vladimirsustek/RadioServer/Doc/SystemPinout.png

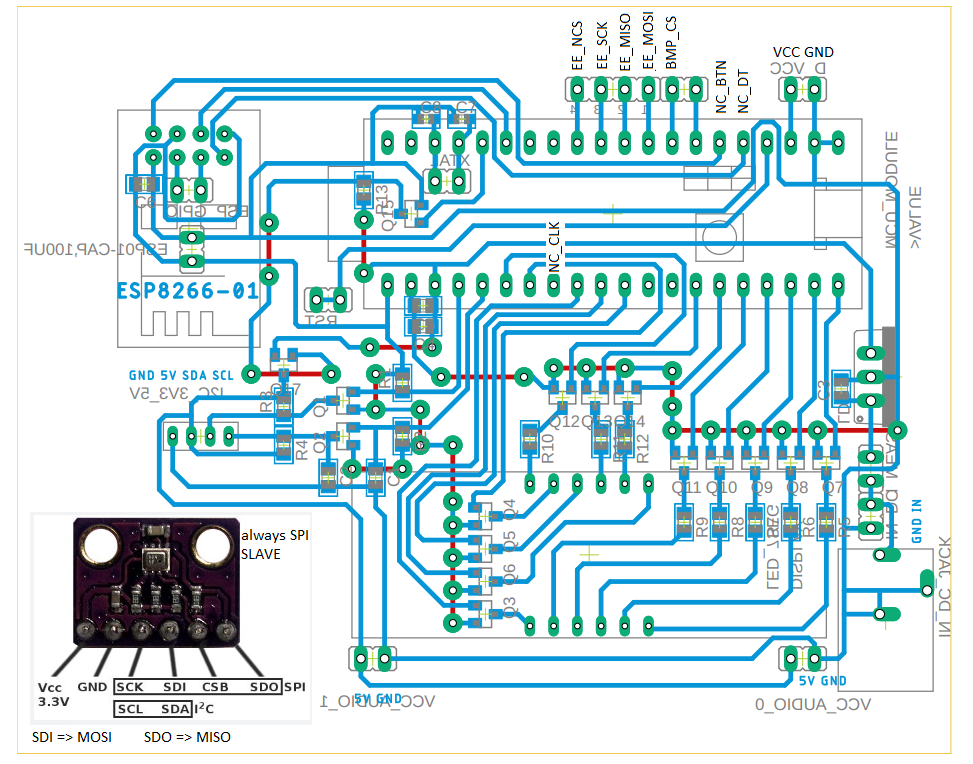
Doc/SystemPinout.png
