vladimirsustek/RadioServer/Hardware/RadioReceiver/RadioRX.pdf

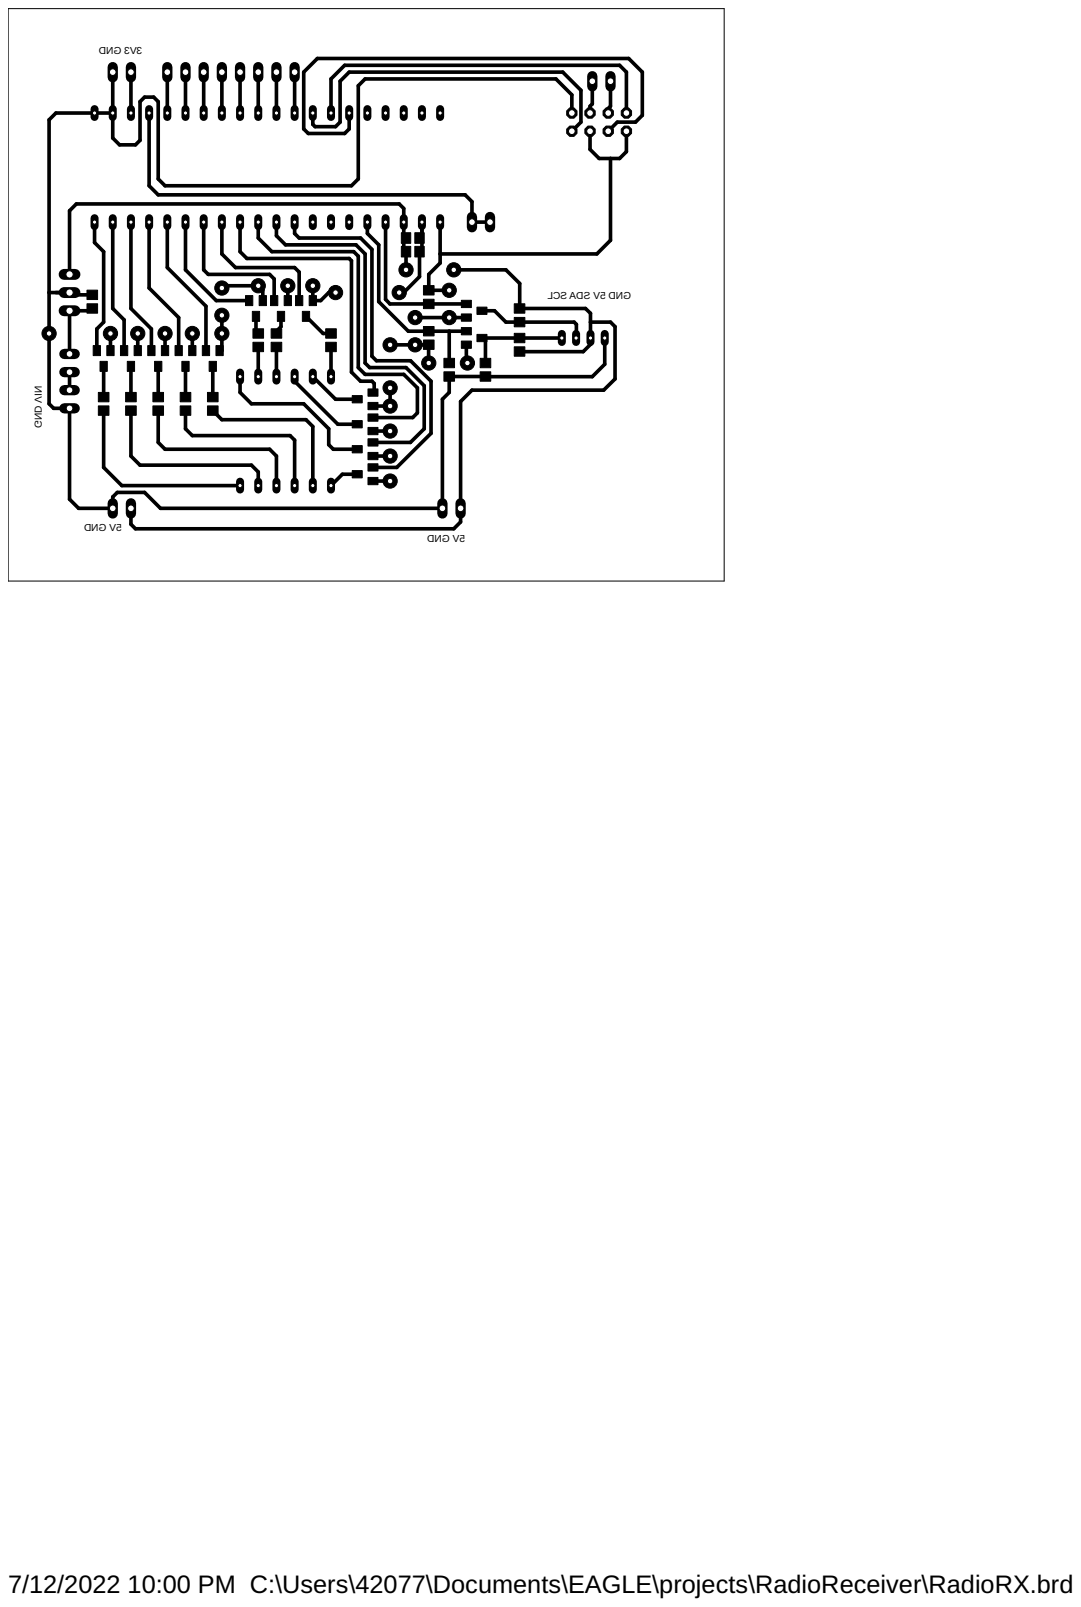
[picture p2: page 1]

7/12/2022 10:00 PM C:\Users\42077\Documents\EAGLE\projects\RadioReceiver\RadioRX.brd
