vladimirsustek/RadioServer/Hardware/RadioReceiver/RadioRX.brd

## EAGLE design Hardware/RadioReceiver/RadioRX.brd (2022-09-20)

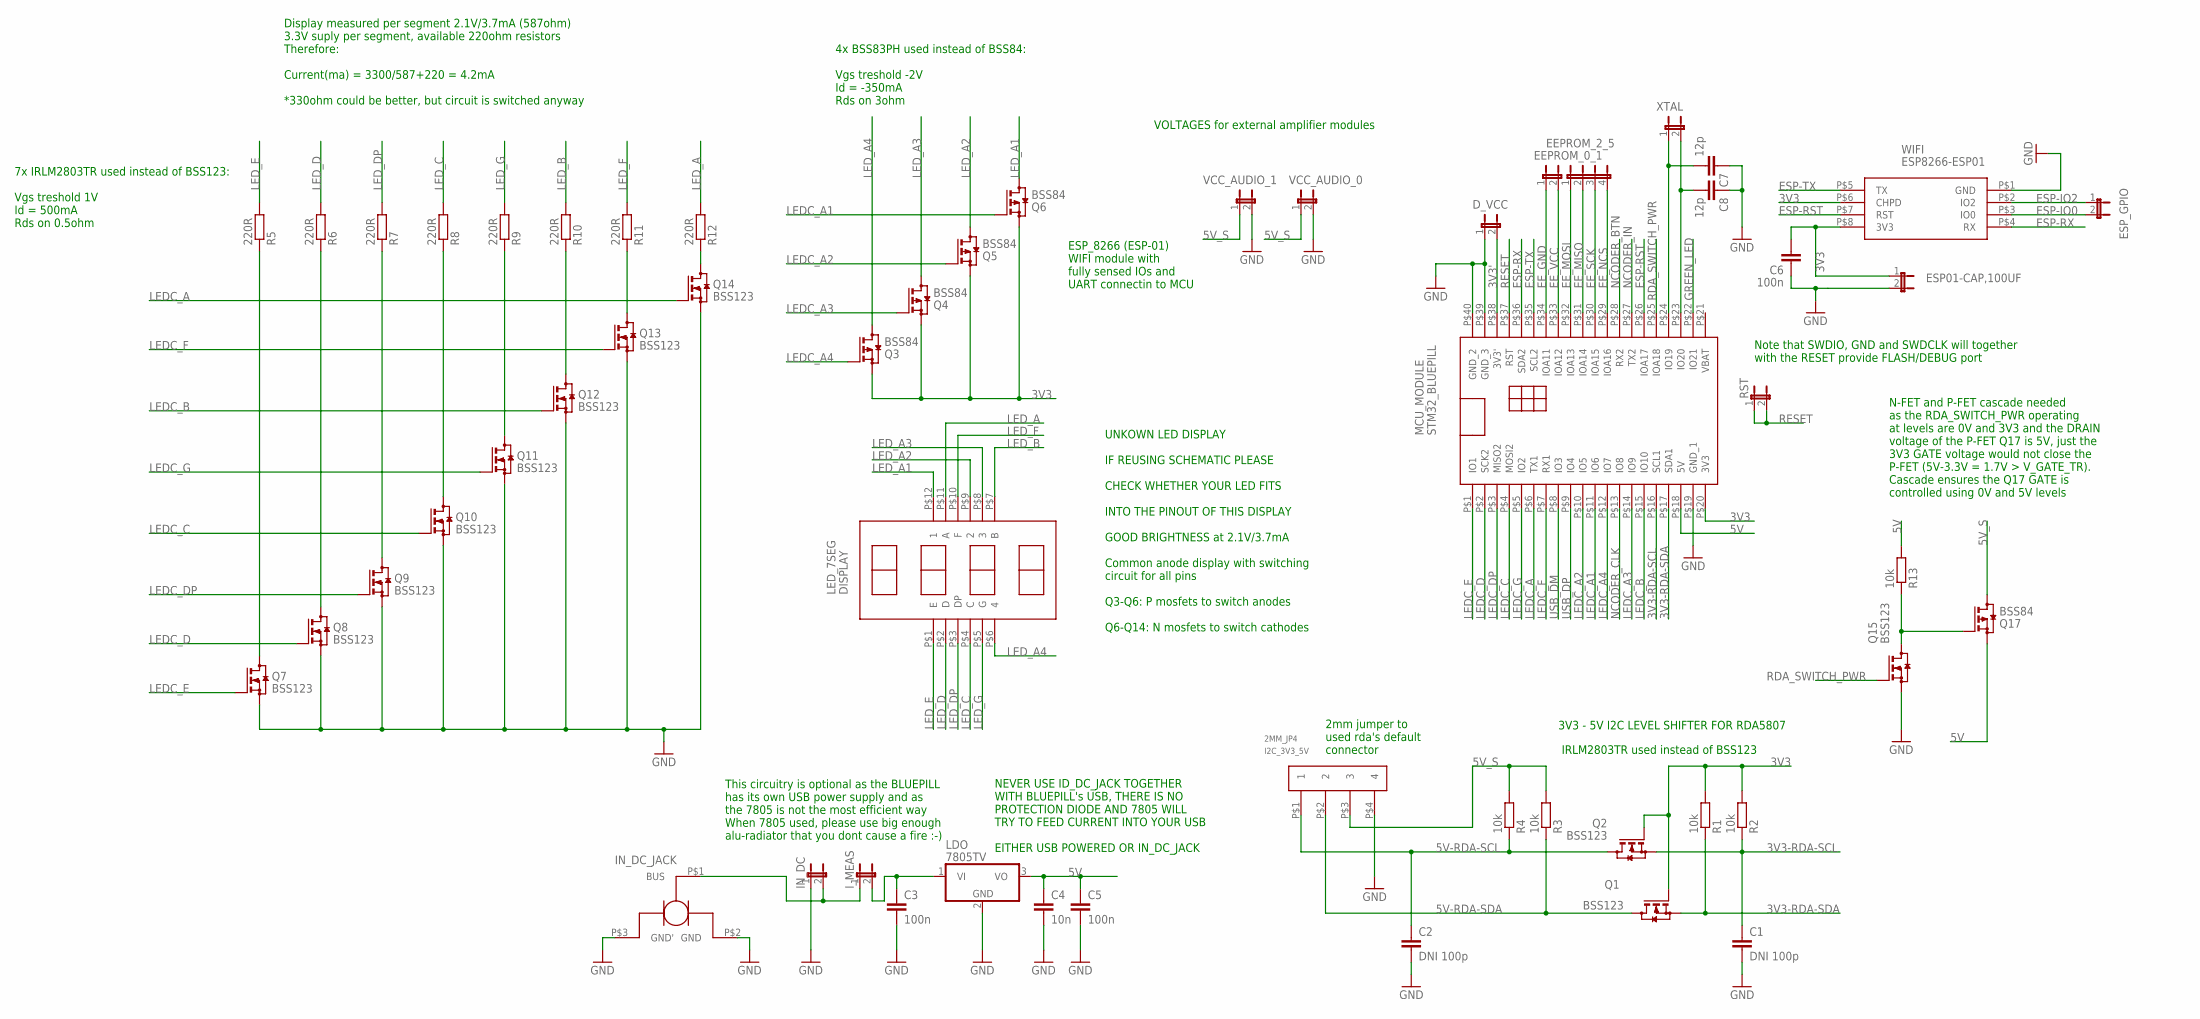
[picture p3: schematic RadioRX.sch]

Parts:
C1, C2: DNI 100p; C0805
C3, C5, C6: 100n; C0805
C4: 10n; C0805
C7, C8: 12p; C0603
DISPLAY: LED_7SEG
D_VCC: JP1E; JP1
EEPROM_0_1: JP1E; JP1
EEPROM_2_5: JP4E; JP4
ESP01-CAP,100UF: JP1E; JP1
ESP_GPIO: JP1E; JP1
I2C_3V3_5V: 2MM_JP4
IN_DC: JP1E; JP1
IN_DC_JACK: DC_CONN
I_MEAS: JP1E; JP1
LDO: 7805TV; TO220V
MCU_MODULE: STM32_BLUEPILL
Q1, Q2, Q7, Q8, Q9, Q10, Q11, Q12, Q13, Q14, Q15: BSS123; SOT23
Q3, Q4, Q5, Q6, Q17: BSS84; SOT23
R1, R2, R3, R4, R13: 10k; R0805
R5, R6, R7, R8, R9, R10, R11, R12: 220R; R0805
RST: JP1E; JP1
VCC_AUDIO_0, VCC_AUDIO_1: JP1E; JP1
WIFI: ESP8266-ESP01
XTAL: JP1E; JP1

Connections:
3V3: C6.2, ESP01-CAP,100UF.1, MCU_MODULE.P$20 (3V3), Q1.1 (G), Q2.1 (G), Q3.2 (S), Q4.2 (S), Q5.2 (S), Q6.2 (S), R1.2, R2.2, WIFI.P$6 (CHPD), WIFI.P$8 (3V3)
3V3': D_VCC.2, MCU_MODULE.P$38 (3V3')
3V3-RDA-SCL: C1.1, MCU_MODULE.P$16 (SCL1), Q2.2 (S), R2.1
3V3-RDA-SDA: MCU_MODULE.P$17 (SDA1), Q1.2 (S), R1.1
5V: C4.1, C5.1, LDO.3 (VO), MCU_MODULE.P$18 (5V), Q17.2 (S), R13.2
5V-RDA-SCL: C2.1, I2C_3V3_5V.P$1 (1), Q2.3 (D), R4.1
5V-RDA-SDA: I2C_3V3_5V.P$2 (2), Q1.3 (D), R3.1
5V_S: I2C_3V3_5V.P$3 (3), Q17.3 (D), R3.2, R4.2, VCC_AUDIO_0.1, VCC_AUDIO_1.1
EE_GND: EEPROM_0_1.1, MCU_MODULE.P$34 (IOA11)
EE_MISO: EEPROM_2_5.2, MCU_MODULE.P$31 (IOA14)
EE_MOSI: EEPROM_2_5.1, MCU_MODULE.P$32 (IOA13)
EE_NCS: EEPROM_2_5.4, MCU_MODULE.P$29 (IOA16)
EE_SCK: EEPROM_2_5.3, MCU_MODULE.P$30 (IOA15)
EE_VCC: EEPROM_0_1.2, MCU_MODULE.P$33 (IOA12)
ESP-IO0: ESP_GPIO.2, WIFI.P$3 (IO0)
ESP-IO2: ESP_GPIO.1, WIFI.P$2 (IO2)
ESP-RST: MCU_MODULE.P$26 (IOA17), WIFI.P$7 (RST)
ESP-RX: MCU_MODULE.P$36 (SDA2), WIFI.P$4 (RX)
ESP-TX: MCU_MODULE.P$35 (SCL2), WIFI.P$5 (TX)
GND: C1.2, C2.2, C3.2, C4.2, C5.2, C6.1, C7.1, C8.1, D_VCC.1, ESP01-CAP,100UF.2, I2C_3V3_5V.P$4 (4), IN_DC.1, IN_DC_JACK.P$2 (GND), IN_DC_JACK.P$3 (GND'), LDO.2 (GND), MCU_MODULE.P$19 (GND_1), MCU_MODULE.P$39 (GND_3), MCU_MODULE.P$40 (GND_2), Q7.2 (S), Q8.2 (S), Q9.2 (S), Q10.2 (S), Q11.2 (S), Q12.2 (S), Q13.2 (S), Q14.2 (S), Q15.2 (S), VCC_AUDIO_0.2, VCC_AUDIO_1.2, WIFI.P$1 (GND)
GREEN_LED: MCU_MODULE.P$22 (IO21)
LEDC_A: MCU_MODULE.P$6 (TX1), Q14.1 (G)
LEDC_A1: MCU_MODULE.P$11 (IO6), Q6.1 (G)
LEDC_A2: MCU_MODULE.P$10 (IO5), Q5.1 (G)
LEDC_A3: MCU_MODULE.P$14 (IO9), Q4.1 (G)
LEDC_A4: MCU_MODULE.P$12 (IO7), Q3.1 (G)
LEDC_B: MCU_MODULE.P$15 (IO10), Q12.1 (G)
LEDC_C: MCU_MODULE.P$4 (MOSI2), Q10.1 (G)
LEDC_D: MCU_MODULE.P$2 (SCK2), Q8.1 (G)
LEDC_DP: MCU_MODULE.P$3 (MISO2), Q9.1 (G)
LEDC_E: MCU_MODULE.P$1 (IO1), Q7.1 (G)
LEDC_F: MCU_MODULE.P$7 (RX1), Q13.1 (G)
LEDC_G: MCU_MODULE.P$5 (IO2), Q11.1 (G)
LED_A: DISPLAY.P$11 (A), R12.2
LED_A1: DISPLAY.P$12 (1), Q6.3 (D)
LED_A2: DISPLAY.P$9 (2), Q5.3 (D)
LED_A3: DISPLAY.P$8 (3), Q4.3 (D)
LED_A4: DISPLAY.P$6 (4), Q3.3 (D)
LED_B: DISPLAY.P$7 (B), R10.2
LED_C: DISPLAY.P$4 (C), R8.2
LED_D: DISPLAY.P$2 (D), R6.2
LED_DP: DISPLAY.P$3 (DP), R7.2
LED_E: DISPLAY.P$1 (E), R5.2
LED_F: DISPLAY.P$10 (F), R11.2
LED_G: DISPLAY.P$5 (G), R9.2
unnamed: C3.1, I_MEAS.2, LDO.1 (VI)
unnamed: IN_DC.2, IN_DC_JACK.P$1 (BUS), I_MEAS.1
unnamed: C8.2, MCU_MODULE.P$23 (IO20), XTAL.2
unnamed: C7.2, MCU_MODULE.P$24 (IO19), XTAL.1
unnamed: Q15.3 (D), Q17.1 (G), R13.1
unnamed: Q7.3 (D), R5.1
unnamed: Q8.3 (D), R6.1
unnamed: Q9.3 (D), R7.1
unnamed: Q10.3 (D), R8.1
unnamed: Q11.3 (D), R9.1
unnamed: Q12.3 (D), R10.1
unnamed: Q13.3 (D), R11.1
unnamed: Q14.3 (D), R12.1
NCODER_BTN: MCU_MODULE.P$28 (RX2)
NCODER_CLK: MCU_MODULE.P$13 (IO8)
NCODER_IN: MCU_MODULE.P$27 (TX2)
RDA_SWITCH_PWR: MCU_MODULE.P$25 (IOA18), Q15.1 (G)
RESET: MCU_MODULE.P$37 (RST), RST.1, RST.2
USB_DM: MCU_MODULE.P$8 (IO3)
USB_DP: MCU_MODULE.P$9 (IO4)

Notes on the sheet:
ESP_8266 (ESP-01) WIFI module with fully sensed IOs and UART connectin to MCU
VOLTAGES for external amplifier modules
3V3 - 5V I2C LEVEL SHIFTER FOR RDA5807
7x IRLM2803TR used instead of BSS123: Vgs treshold 1V Id = 500mA Rds on 0.5ohm
4x BSS83PH used instead of BSS84: Vgs treshold -2V Id = -350mA Rds on 3ohm
UNKOWN LED DISPLAY IF REUSING SCHEMATIC PLEASE CHECK WHETHER YOUR LED FITS INTO THE PINOUT OF THIS DISPLAY GOOD BRIGHTNESS at 2.1V/3.7mA Common anode display with switching circuit for all pins Q3-Q6: P mosfets to switch anodes Q6-Q14: N mosfets to switch cathodes
2mm jumper to used rda's default connector
IRLM2803TR used instead of BSS123
Display measured per segment 2.1V/3.7mA (587ohm) 3.3V suply per segment, available 220ohm resistors Therefore: Current(ma) = 3300/587+220 = 4.2mA *330ohm could be better, but circuit is switched anyway
Note that SWDIO, GND and SWDCLK will together with the RESET provide FLASH/DEBUG port
N-FET and P-FET cascade needed as the RDA_SWITCH_PWR operating at levels are 0V and 3V3 and the DRAIN voltage of the P-FET Q17 is 5V, just the 3V3 GATE voltage would not close the P-FET (5V-3.3V = 1.7V > V_GATE_TR). Cascade ensures the Q17 GATE is controlled using 0V and 5V levels
This circuitry is optional as the BLUEPILL has its own USB power supply and as the 7805 is not the most efficient way When 7805 used, please use big enough alu-radiator that you dont cause a fire :-)
NEVER USE ID_DC_JACK TOGETHER WITH BLUEPILL's USB, THERE IS NO PROTECTION DIODE AND 7805 WILL TRY TO FEED CURRENT INTO YOUR USB EITHER USB POWERED OR IN_DC_JACK

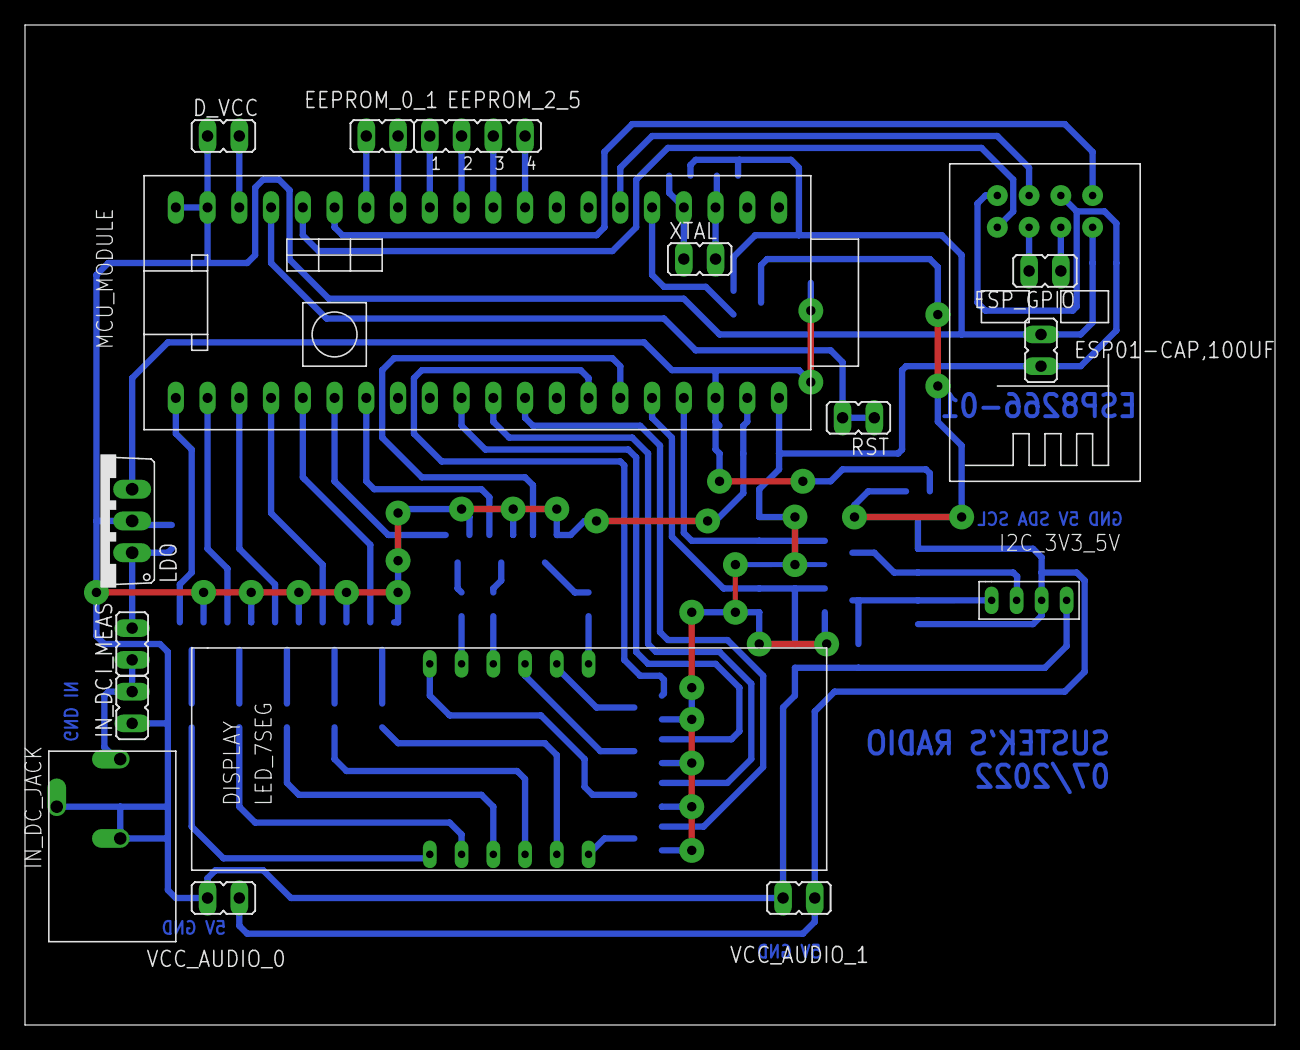
[picture p4: board RadioRX.brd from above]

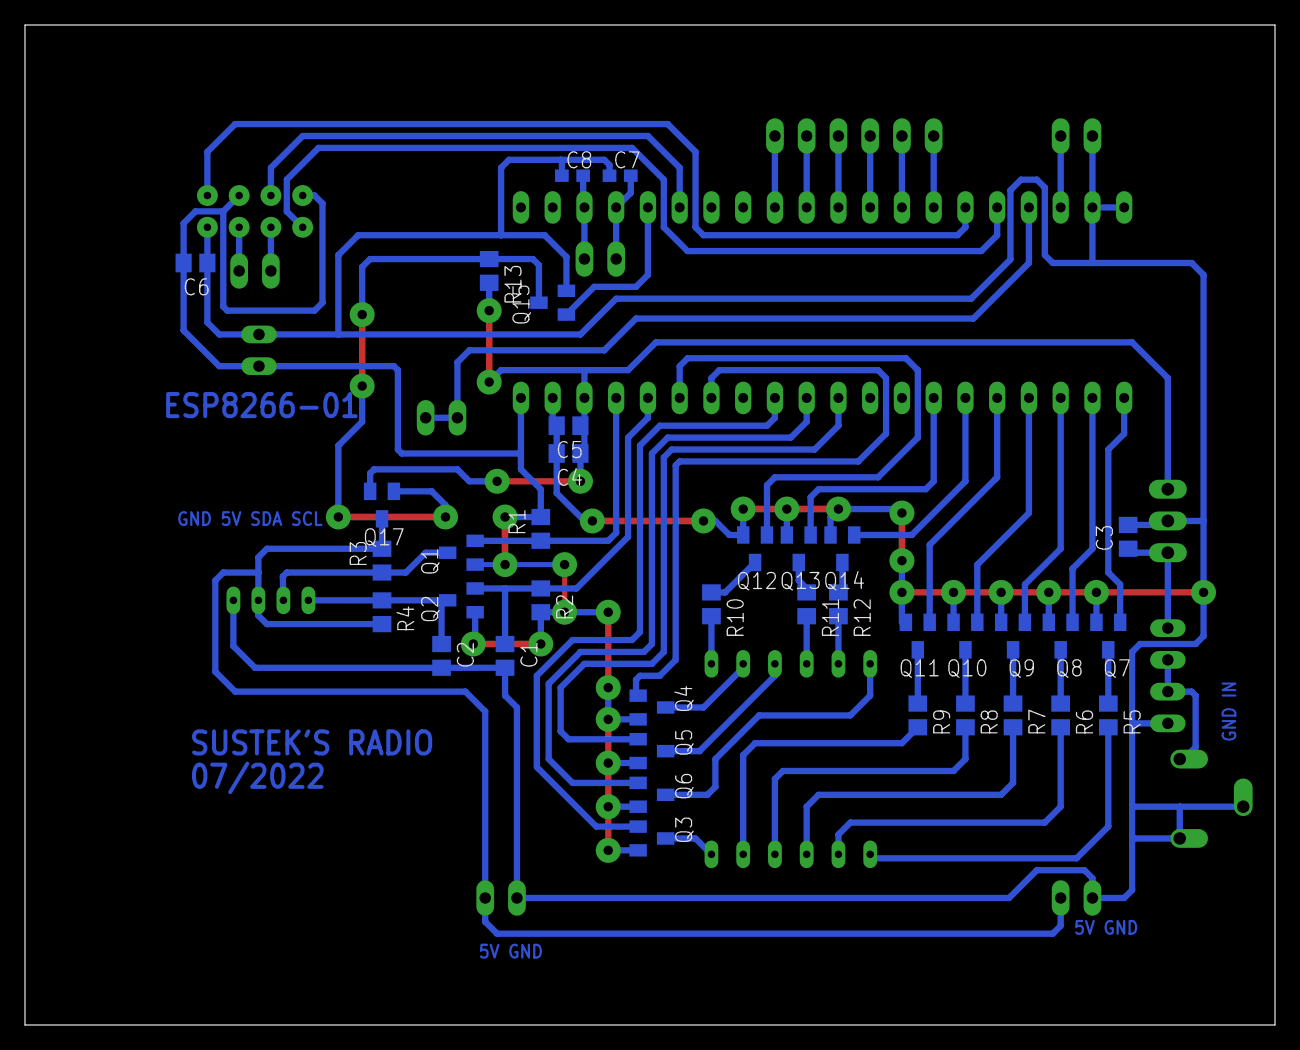
[picture p5: board RadioRX.brd from below]

Board: 2 copper layers, 100.0 x 80.0 mm, 54 parts (37 on the bottom side), 59 nets.
