vladimirsustek/RadioServer/Hardware/RadioReceiver/EEPROM_Modul.brd

## EAGLE design Hardware/RadioReceiver/EEPROM_Modul.brd (2022-09-02)

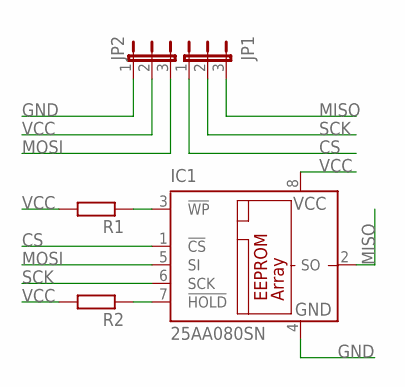
[picture p6: schematic EEPROM_Modul.sch]

Parts:
IC1: 25AA080SN; SO-08
JP1, JP2: JP2E; JP2
R1, R2: R-EU_R0805; R0805

Connections:
CS: IC1.1 (!CS), JP1.1
GND: IC1.4 (GND), JP2.1
MISO: IC1.2 (SO), JP1.3
MOSI: IC1.5 (SI), JP2.3
unnamed: IC1.3 (!WP), R1.1
unnamed: IC1.7 (!HOLD), R2.1
SCK: IC1.6 (SCK), JP1.2
VCC: IC1.8 (VCC), JP2.2, R1.2, R2.2

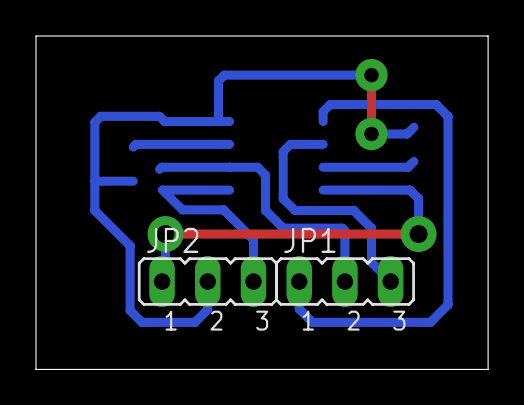
[picture p7: board EEPROM_Modul.brd from above]

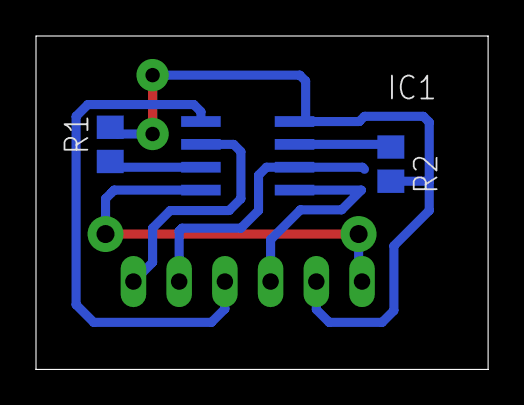
[picture p8: board EEPROM_Modul.brd from below]

Board: 2 copper layers, 25.1 x 18.5 mm, 5 parts (3 on the bottom side), 8 nets.
