vladimirsustek/RadioServer/Core/Src/main.c

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
/* Includes ------------------------------------------------------------------*/
#include "main.h"
#include "dma.h"
#include "i2c.h"
#include "rtc.h"
#include "spi.h"
#include "tim.h"
#include "usart.h"
#include "usb_device.h"
#include "gpio.h"

/* USER CODE BEGIN Includes */
#include <string.h>
#include <stdio.h>

#include "stm32f1xx_hal_conf.h"
#include "usbd_cdc_if.h"

#include "esp8266_http_server.h"
#include "rda5807m.h"
#include "cmd_dispatcher.h"
#include "eeprom_25aa1024.h"

#include "bmp280.h"
#include "app.h"
/* USER CODE END Includes */


/* USER CODE BEGIN PV */
UART_HandleTypeDef huart2;
DMA_HandleTypeDef hdma_usart2_rx;

/* USER CODE END PV */

void SystemClock_Config(void);
/**
  * @brief  The application entry point.
  * @retval int
  */
int main(void)
{
  /* USER CODE BEGIN 1 */
	uint8_t* rxStrBuff = NULL;
	char *pHTTPReq = NULL;
	char stateMessage[APP_MESSAGE_LNG] = {0};
    uint32_t rxStrlng;
    uint32_t httpReqLng = 0;
    RTC_TimeTypeDef rtcStruct = {0};

  /* USER CODE END 1 */

  /* MCU Configuration--------------------------------------------------------*/

  /* Reset of all peripherals, Initializes the Flash interface and the Systick. */
  HAL_Init();

  /* Configure the system clock */
  SystemClock_Config();

  /* USER CODE BEGIN SysInit */
  APP_ShortcutUSB();
  /* USER CODE END SysInit */

  /* Initialize all configured peripherals */
  MX_GPIO_Init();
  MX_I2C1_Init();
  MX_TIM2_Init();
  MX_DMA_Init();
  MX_USB_DEVICE_Init();
  MX_USART3_UART_Init();
  MX_SPI1_Init();
  MX_RTC_Init();
  /* USER CODE BEGIN 2 */

  APP_LEDC_DisplayInit();
  APP_BMP280_SensorInit();
  APP_EEPROM_CheckIfOk();
  APP_RDA5807M_RadioInit();
  APP_RTC_Init();

  if (systemGlobalState.states.espEnabled)
  {
	  APP_ESP_InitConnect();
  }

  APPP_NCoderStart();

  /* USER CODE END 2 */

  /* Infinite loop */
  /* USER CODE BEGIN WHILE */
  while (1)
  {
    /* USER CODE END WHILE */

    /* USER CODE BEGIN 3 */

	  // VCOM RX routine
      rxStrBuff = VCOMFetchReceivedLine(&rxStrlng);

      if (NULL != rxStrBuff)
      {
          /* If so and is terminated by <LF>,
             process it as command*/
    	  BluePill_SetBlinkState(THREE_BLINKS);
          CmdDispatch(rxStrBuff, rxStrlng);
      }

	  if (systemGlobalState.states.espEnabled)
	  {
	      // Function returns ESP_RET_OK when HTTP request received
	      if(ESP_RET_OK == ESP_CheckReceiveHTTP(&pHTTPReq, &httpReqLng))
	      {
	    	  // Process the request
	    	  BluePill_SetBlinkState(THREE_BLINKS);
	          ESP_ProcessHTTP(pHTTPReq, httpReqLng);
	      }
	  }

      // If triggered display frequency, volume or time HH:MM settings
      if (NO_SETTINGS_ONGOING == APP_UserInput(stateMessage, &rtcStruct))
      {
          // Periodic time/temp display + fault detection
          APP_ModuleCheckStates(stateMessage, &rtcStruct);
      }

  }
  /* USER CODE END 3 */
}

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
