vladimirsustek/RadioServer/Core/Inc/main.h

#define GREEN_LED_Pin GPIO_PIN_13
#define GREEN_LED_GPIO_Port GPIOC
#define RDA_SWITCH_PWR_Pin GPIO_PIN_0
#define RDA_SWITCH_PWR_GPIO_Port GPIOA
#define ESP_RST_Pin GPIO_PIN_1
#define ESP_RST_GPIO_Port GPIOA
#define NCODER_DT_Pin GPIO_PIN_3
#define NCODER_DT_GPIO_Port GPIOA
#define NCODER_BTN_Pin GPIO_PIN_2
#define NCODER_BTN_GPIO_Port GPIOA
#define SPI1_NCS_Pin GPIO_PIN_4
#define SPI1_NCS_GPIO_Port GPIOA
#define BMP_CS_Pin GPIO_PIN_0
#define BMP_CS_GPIO_Port GPIOB
#define LEDC_E_Pin GPIO_PIN_12
#define LEDC_E_GPIO_Port GPIOB
#define LEDC_D_Pin GPIO_PIN_13
#define LEDC_D_GPIO_Port GPIOB
#define LEDC_DP_Pin GPIO_PIN_14
#define LEDC_DP_GPIO_Port GPIOB
#define LEDC_C_Pin GPIO_PIN_15
#define LEDC_C_GPIO_Port GPIOB
#define LEDC_G_Pin GPIO_PIN_8
#define LEDC_G_GPIO_Port GPIOA
#define LEDC_A_Pin GPIO_PIN_9
#define LEDC_A_GPIO_Port GPIOA
#define LEDC_F_Pin GPIO_PIN_10
#define LEDC_F_GPIO_Port GPIOA
#define LEDC_A2_Pin GPIO_PIN_15
#define LEDC_A2_GPIO_Port GPIOA
#define LEDC_A1_Pin GPIO_PIN_3
#define LEDC_A1_GPIO_Port GPIOB
#define LEDC_A4_Pin GPIO_PIN_4
#define LEDC_A4_GPIO_Port GPIOB
#define NCODER_CLK_Pin GPIO_PIN_5
#define NCODER_CLK_GPIO_Port GPIOB
#define LEDC_B_Pin GPIO_PIN_6
#define LEDC_B_GPIO_Port GPIOB
#define LEDC_A3_Pin GPIO_PIN_7
#define LEDC_A3_GPIO_Port GPIOB
