vladimirsustek/RadioServer/Core/Src/gpio.c

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

/* Includes ------------------------------------------------------------------*/
#include "gpio.h"

/* USER CODE BEGIN 0 */
static BluePillGreenLed_t blinkState = NO_BLINK;
static uint8_t div200to20Hz = 0;
static uint8_t intState = 0;
/* USER CODE END 0 */

/*----------------------------------------------------------------------------*/
/* Configure GPIO                                                             */
/*----------------------------------------------------------------------------*/
/** Configure pins as
        * Analog
        * Input
        * Output
        * EVENT_OUT
        * EXTI
        * Free pins are configured automatically as Analog (this feature is enabled through
        * the Code Generation settings)
*/
void MX_GPIO_Init(void)
{

  GPIO_InitTypeDef GPIO_InitStruct = {0};

  /* GPIO Ports Clock Enable */
  __HAL_RCC_GPIOC_CLK_ENABLE();
  __HAL_RCC_GPIOD_CLK_ENABLE();
  __HAL_RCC_GPIOA_CLK_ENABLE();
  __HAL_RCC_GPIOB_CLK_ENABLE();

  /*Configure GPIO pin Output Level */
  HAL_GPIO_WritePin(GREEN_LED_GPIO_Port, GREEN_LED_Pin, GPIO_PIN_SET);

  /*Configure GPIO pin Output Level */
  HAL_GPIO_WritePin(GPIOA, RDA_SWITCH_PWR_Pin|LEDC_G_Pin|LEDC_A_Pin|LEDC_F_Pin, GPIO_PIN_RESET);

  /*Configure GPIO pin Output Level */
  HAL_GPIO_WritePin(GPIOA, SPI1_NCS_Pin|LEDC_A2_Pin, GPIO_PIN_SET);

  /*Configure GPIO pin Output Level */
  HAL_GPIO_WritePin(GPIOB, BMP_CS_Pin|LEDC_A1_Pin|LEDC_A4_Pin|LEDC_A3_Pin, GPIO_PIN_SET);

  /*Configure GPIO pin Output Level */
  HAL_GPIO_WritePin(GPIOB, LEDC_E_Pin|LEDC_D_Pin|LEDC_DP_Pin|LEDC_C_Pin
                          |LEDC_B_Pin, GPIO_PIN_RESET);

  /*Configure GPIO pin : PtPin */
  GPIO_InitStruct.Pin = GREEN_LED_Pin;
  GPIO_InitStruct.Mode = GPIO_MODE_OUTPUT_PP;
  GPIO_InitStruct.Pull = GPIO_NOPULL;
  GPIO_InitStruct.Speed = GPIO_SPEED_FREQ_LOW;
  HAL_GPIO_Init(GREEN_LED_GPIO_Port, &GPIO_InitStruct);

  /*Configure GPIO pins : PAPin PAPin PAPin PAPin
                           PAPin */
  GPIO_InitStruct.Pin = RDA_SWITCH_PWR_Pin|LEDC_G_Pin|LEDC_A_Pin|LEDC_F_Pin
                          |LEDC_A2_Pin;
  GPIO_InitStruct.Mode = GPIO_MODE_OUTPUT_PP;
  GPIO_InitStruct.Pull = GPIO_NOPULL;
  GPIO_InitStruct.Speed = GPIO_SPEED_FREQ_LOW;
  HAL_GPIO_Init(GPIOA, &GPIO_InitStruct);

  /*Configure GPIO pins : PAPin PAPin PAPin */
  GPIO_InitStruct.Pin = ESP_RST_Pin|NCODER_DT_Pin|NCODER_BTN_Pin;
  GPIO_InitStruct.Mode = GPIO_MODE_INPUT;
  GPIO_InitStruct.Pull = GPIO_NOPULL;
  HAL_GPIO_Init(GPIOA, &GPIO_InitStruct);

  /*Configure GPIO pin : PtPin */
  GPIO_InitStruct.Pin = SPI1_NCS_Pin;
  GPIO_InitStruct.Mode = GPIO_MODE_OUTPUT_PP;
  GPIO_InitStruct.Pull = GPIO_NOPULL;
  GPIO_InitStruct.Speed = GPIO_SPEED_FREQ_HIGH;
  HAL_GPIO_Init(SPI1_NCS_GPIO_Port, &GPIO_InitStruct);

  /*Configure GPIO pins : PBPin PBPin PBPin PBPin
                           PBPin PBPin PBPin PBPin
                           PBPin */
  GPIO_InitStruct.Pin = BMP_CS_Pin|LEDC_E_Pin|LEDC_D_Pin|LEDC_DP_Pin
                          |LEDC_C_Pin|LEDC_A1_Pin|LEDC_A4_Pin|LEDC_B_Pin
                          |LEDC_A3_Pin;
  GPIO_InitStruct.Mode = GPIO_MODE_OUTPUT_PP;
  GPIO_InitStruct.Pull = GPIO_NOPULL;
  GPIO_InitStruct.Speed = GPIO_SPEED_FREQ_LOW;
  HAL_GPIO_Init(GPIOB, &GPIO_InitStruct);

  /*Configure GPIO pins : PB1 PB2 */
  GPIO_InitStruct.Pin = GPIO_PIN_1|GPIO_PIN_2;
  GPIO_InitStruct.Mode = GPIO_MODE_ANALOG;
  HAL_GPIO_Init(GPIOB, &GPIO_InitStruct);

  /*Configure GPIO pin : PtPin */
  GPIO_InitStruct.Pin = NCODER_CLK_Pin;
  GPIO_InitStruct.Mode = GPIO_MODE_INPUT;
  GPIO_InitStruct.Pull = GPIO_NOPULL;
  HAL_GPIO_Init(NCODER_CLK_GPIO_Port, &GPIO_InitStruct);

}

/* USER CODE BEGIN 2 */

// to be called 1x per 50ms
void BluePill_GreenLedService(void)
{
	if (0 == div200to20Hz)
	{
		div200to20Hz = (div200to20Hz + 1 % 20);

		switch(blinkState)
		{
		case ONCE_BLINK :
		{
			if (0 == intState)
			{
				HAL_GPIO_WritePin(GREEN_LED_GPIO_Port, GREEN_LED_Pin, GPIO_PIN_RESET);
			}
			else
			{
				HAL_GPIO_WritePin(GREEN_LED_GPIO_Port, GREEN_LED_Pin, GPIO_PIN_SET);
			}
			intState = (intState + 1) % 10;
			if (0 == intState) blinkState = NO_BLINK;
		}
		break;
		case THREE_BLINKS :
		{
			switch(intState)
			{
			case 0:
			case 2:
			case 4:
			{
				HAL_GPIO_WritePin(GREEN_LED_GPIO_Port, GREEN_LED_Pin, GPIO_PIN_RESET);
			}
			break;
			default :
			{
				HAL_GPIO_WritePin(GREEN_LED_GPIO_Port, GREEN_LED_Pin, GPIO_PIN_SET);
			}
			}
			intState = (intState + 1) % 10;
			if (0 == intState) blinkState = NO_BLINK;
		}
		break;
		case PERMANENT_BLINK :
		{
			HAL_GPIO_TogglePin(GREEN_LED_GPIO_Port, GREEN_LED_Pin);
			intState = 0;
		}
		break;
		default :
		{
			blinkState = NO_BLINK;

			/* If LED is on turn it off */
			if (!HAL_GPIO_ReadPin(GREEN_LED_GPIO_Port, GREEN_LED_Pin))
				HAL_GPIO_WritePin(GREEN_LED_GPIO_Port, GREEN_LED_Pin, GPIO_PIN_SET);
		}
		break;
		}
	}
	else
	{
		div200to20Hz = (div200to20Hz + 1) % 20;
	}

}

void BluePill_SetBlinkState(BluePillGreenLed_t st)
{
	blinkState = st;
	div200to20Hz = 0;
	intState = 0;
}

/* USER CODE END 2 */
