vladimirsustek/RadioServer/rda5807m/Src/rda5807m.c

#include "rda5807m.h"

/* If this define is 1, RDS settings across all
   functions are applied .. otherwise not */
#define RDS_USED            1

/* byte endianity solving macro for 16b variable*/
#define swapbytes(byte)     ((((byte) & 0x00FF) << 8) | (((byte) & 0xFF00) >> 8))

I2C_HandleTypeDef hi2c1;

static void twi_readFromSlave(uint8_t DevAddress, uint8_t *pData, uint16_t Size)
{
	HAL_I2C_Master_Receive(&hi2c1, DevAddress, pData, Size, HAL_MAX_DELAY);
}

static void twi_writeToSlave(uint8_t DevAddress, uint8_t *pData, uint16_t Size)
{
	HAL_I2C_Master_Transmit(&hi2c1, DevAddress, pData, Size, HAL_MAX_DELAY);

}
static uint16_t RDA5807mGetReg0x0A(void) {

    uint16_t RDA5807MReg = 0;

    twi_readFromSlave(RDA5807M_I2C_ADR, (uint8_t*)&RDA5807MReg, RDA5807M_REG_SIZE);
    RDA5807MReg = swapbytes(RDA5807MReg);

    return (uint32_t)RDA5807MReg;
}

static uint16_t RDA5807mGetReg0x0B(void) {

    uint16_t RDA5807MReg[2] = {0};

    twi_readFromSlave(RDA5807M_I2C_ADR, (uint8_t*)&RDA5807MReg, RDA5807M_REG_SIZE*2);
    RDA5807MReg[1] = swapbytes(RDA5807MReg[1]);

    return (uint32_t)RDA5807MReg[1];
}
#if REAL_RESET
__weak void RDA5807mReset(void) {

    /* For Mute only 1st register needed to be accessed */

    uint16_t RDA5807Register = {0};
	/* Register REG_ADR_02 */
	RDA5807Register = (1 << SOFT_RESET);

    RDA5807Register = swapbytes(RDA5807Register);

    twi_writeToSlave(RDA5807M_I2C_ADR, (uint8_t*)&RDA5807Register, RDA5807M_REG_SIZE);
}
#endif
void RDA5807mReset(void)
{
	RDA5807mPowerOff();
}

void RDA5807mInit(uint16_t freq, uint8_t volm)
{

	/* Power up and wait */
	//RDA5807mReset();
	RDA5807mPowerOn();

    freq -= RDA5807mWW_FREQ_MIN;
    freq /= 10;
    freq <<= CHAN_0;

    /* For complete initialization, 6 (out of 7) registers must be written */
    uint16_t RDA5807Registers[6] = {0};
	/* Register REG_ADR_02 */
#if RDS_USED
    RDA5807Registers[0] = (1 << DHIZ) | (1 << DMUTE) | (1 << BASS) | (1 << RCLK_DIR_MODE) | (1 << RDS_EN) | (1 << ENABLE);
#else
    RDA5807Registers[0] = (1 << DHIZ) | (1 << BASS) | (1 << RCLK_DIR_MODE) | (1 << ENABLE);
#endif
	/* Register REG_ADR_03 */
	RDA5807Registers[1] = freq | (1 << TUNE) | (1 << BAND_1) ;
	/* Register REG_ADR_04 */
#if RDS_USED
	RDA5807Registers[2] = (1 << RDS_FIFO_EN) | (1 << RDS_FIFO_CLR);
#else
    RDA5807Registers[2]= 0u;
#endif
	/* Register REG_ADR_05 */
	RDA5807Registers[3] = (1 << LNA_PORT_SEL_1) | (1 << LNA_ICSEL_1) | volm;
    /* Register REG_ADR_06 */
    RDA5807Registers[4] = 0u;
    /* Register REG_ADR_07 */
	RDA5807Registers[5] = (1 << TH_SOFRBLEND_4) | (1 << SEEK_TH_OLD_2) | (1 << SOFTBLEND_EN);

    for(uint8_t idx = 0; idx < 6; idx++) {

        RDA5807Registers[idx] = swapbytes(RDA5807Registers[idx]);
    }

    twi_writeToSlave(RDA5807M_I2C_ADR, (uint8_t*)RDA5807Registers, RDA5807M_REG_SIZE*6);

}

uint16_t RDA5807mSetFreq(uint16_t freq) {

    if (RDA5807mWW_FREQ_MIN > freq || RDA5807mWW_FREQ_MAX < freq)
        return RDA5807M_FN_ER;

    /* For frequency change 2nd register must be accessed */
    uint16_t RDA5807Registers[2] = {0};

#if RDS_USED
    RDA5807Registers[0] = (1 << DHIZ)| (1 << DMUTE) | (1 << BASS)| (1 << RCLK_DIR_MODE) | (1 << RDS_EN) | (1 << ENABLE);
#else
    RDA5807Registers[0] = (1 << DHIZ)| (1 << DMUTE) | (1 << BASS)| (1 << RCLK_DIR_MODE)| (1 << ENABLE);
#endif

    /* Channel (frequency select) is based on:
       SPACE - Channel Spacing (SPACE_0, SPACE_1)
       CHAN - Input offset of base frequency
       BAND - Baseband frequency (BAND_1, BAND_0)

       Freq = SPACE(kHz)*CHAN + BAND
       e.g. Freq = 132 + 760 = 89.2MHz
    */

    freq -= RDA5807mWW_FREQ_MIN;
    freq /= 10;
    freq <<= CHAN_0;

    RDA5807Registers[1] = freq | (1 << TUNE) | (1 << BAND_1);

    RDA5807Registers[0] = swapbytes(RDA5807Registers[0]);
    RDA5807Registers[1] = swapbytes(RDA5807Registers[1]);

    twi_writeToSlave(RDA5807M_I2C_ADR, (uint8_t*)RDA5807Registers, 4);

    return RDA5807M_FN_OK;
}

uint16_t RDA5807mSetVolm(uint8_t volume) {

    if (volume > RDA5807mVOLUME_MAX)
        return RDA5807M_FN_ER;
    /* To set volume, 4th register must be accessed,
       so 4x16b write transaction is needed */
    uint16_t RDA5807Registers[4] = {0};
	/* Register REG_ADR_02 */
#if RDS_USED
    RDA5807Registers[0] = (1 << DHIZ)| (1 << DMUTE) | (1 << BASS)| (1 << RCLK_DIR_MODE) | (1 << RDS_EN) | (1 << ENABLE);
#else
    RDA5807Registers[0] = (1 << DHIZ)| (1 << DMUTE) | (1 << BASS)| (1 << RCLK_DIR_MODE)| (1 << ENABLE);
#endif	/* Register REG_ADR_03 */
	RDA5807Registers[1] = 0 ;
	/* Register REG_ADR_04 */

#if RDS_USED
	RDA5807Registers[2] = (1 << RDS_FIFO_EN) | (1 << RDS_FIFO_CLR);
#else
    RDA5807Registers[2] = 0u;
#endif
	/* Register REG_ADR_05 */
	RDA5807Registers[3] = (1 << INT_MODE) | (1 << SEEK_MODE_1)  | (1 << SEEKTH_1)| (1 << SEEKTH_0) | (1 << LNA_PORT_SEL_1) | (1 << LNA_ICSEL_1) | volume;

    for(uint8_t idx = 0; idx < 4; idx++)
    {
    	RDA5807Registers[idx] = swapbytes(RDA5807Registers[idx]);
    }

    twi_writeToSlave(RDA5807M_I2C_ADR, (uint8_t*)RDA5807Registers, 8);

    return RDA5807M_FN_OK;
}

uint16_t RDA5807mMute(uint8_t mute) {

    if (mute != 0 && mute != 1)
        return RDA5807M_FN_ER;

    uint16_t RDA5807Register;
    /* For Mute only 1st register needed to be accessed */
#if RDS_USED
    RDA5807Register = (1 << DHIZ) | (1 << BASS) | (1 << RCLK_DIR_MODE) | (1 << RDS_EN) | (1 << ENABLE);
#else
    RDA5807Register = (1 << DHIZ) | (1 << BASS) | (1 << RCLK_DIR_MODE) | (1 << ENABLE);
#endif
    if (0 == mute) {
        RDA5807Register |= (1 << DMUTE);
    }

    RDA5807Register = swapbytes(RDA5807Register);

    twi_writeToSlave(RDA5807M_I2C_ADR, (uint8_t*)&RDA5807Register, RDA5807M_REG_SIZE);

    return RDA5807M_FN_OK;

}

uint16_t RDA5807mGetRSSI(void) {

    uint16_t RDA5807MReg;

    RDA5807MReg = RDA5807mGetReg0x0B();

    /* Masking only RSSI bits 15:9 */
    RDA5807MReg &= ((1 << RSSI_6) | (1 << RSSI_5) | (1 << RSSI_4) | (1 << RSSI_3) | (1 << RSSI_2) | (1 << RSSI_1) | (1 << RSSI_0));

    /* Shifting value to be within 6:0 */
    RDA5807MReg >>= RSSI_0;

    return RDA5807MReg;

}

uint16_t RDA5807mGetRDSR(void) {

    uint16_t RDA5807MReg = RDA5807mGetReg0x0A();

    return (RDA5807MReg & (1 << RDSR)) >> (RDSR);
}

uint16_t RDA5807mGetRDSS(void) {

    uint16_t RDA5807MReg = RDA5807mGetReg0x0A();

    return (RDA5807MReg & (1 << RDSS)) >> (RDSS);

}

uint16_t RDA5807mIsChannelStereo(void) {

    uint16_t RDA5807MReg = RDA5807mGetReg0x0A();

    return (RDA5807MReg & (1 << ST)) >> (ST);
}

uint16_t RDA5807mIsChannelStation(void) {

    uint16_t RDA5807MReg = RDA5807mGetReg0x0B();

    return (RDA5807MReg & (1 << FM_TRUE)) >> (FM_TRUE);
}

uint16_t RDA5807mGetRDSBlockA(void) {

    uint8_t Registers[6] = {0};
    uint16_t RDA5807MReg;

    twi_readFromSlave(RDA5807M_I2C_ADR, Registers, 6);
    RDA5807MReg = ((Registers[4] << 8 )| Registers[5]);

    return RDA5807MReg;
}

uint16_t RDA5807mGetRDSBlockB(void) {

    uint8_t Registers[8] = {0};
    uint16_t RDA5807MReg;

    twi_readFromSlave(RDA5807M_I2C_ADR, Registers, 8);
    RDA5807MReg = ((Registers[6] << 8 )| Registers[7]);

    return RDA5807MReg;
}

uint16_t RDA5807mGetRDSBlockC(void) {

    uint8_t Registers[10] = {0};
    uint16_t RDA5807MReg;

    twi_readFromSlave(RDA5807M_I2C_ADR, Registers, 10);
    RDA5807MReg = ((Registers[8] << 8 )| Registers[9]);

    return RDA5807MReg;
}

uint16_t RDA5807mGetRDSBlockD(void) {

    uint8_t Registers[12] = {0};
    uint16_t RDA5807MReg;

    twi_readFromSlave(RDA5807M_I2C_ADR, Registers, 12);
    RDA5807MReg = ((Registers[10] << 8 )| Registers[11]);

    return RDA5807MReg;
}

uint16_t RDA5807mGetErrBlockA(void) {

    uint16_t RDA5807MReg;

	RDA5807MReg = RDA5807mGetReg0x0B();

    RDA5807MReg &= (1 << BLERA_1) | (1 << BLERA_0);
    RDA5807MReg >>= BLERA_0;

    return RDA5807MReg;
}

uint16_t RDA5807mGetErrBlockB(void) {

    uint16_t RDA5807MReg;

	RDA5807MReg = RDA5807mGetReg0x0B();

    RDA5807MReg &= (1 << BLERB_1) | (1 << BLERB_0);
    RDA5807MReg >>= BLERB_0;

    return RDA5807MReg;
}


void RDA5807mClearRDSFIFO(void) {

    uint16_t RDA5807Registers[3] = {0};
	/* Register REG_ADR_02 */
#if RDS_USED
    RDA5807Registers[0] = (1 << DHIZ)| (1 << DMUTE) | (1 << BASS)| (1 << RCLK_DIR_MODE) | (1 << RDS_EN) | (1 << ENABLE);
#else
    RDA5807Registers[0] = (1 << DHIZ)| (1 << DMUTE) | (1 << BASS)| (1 << RCLK_DIR_MODE)| (1 << ENABLE);
#endif	/* Register REG_ADR_03 */
	RDA5807Registers[1] = 0 ;
	/* Register REG_ADR_04 */

#if RDS_USED
	RDA5807Registers[2] = (1 << RDS_FIFO_EN) | (1 << RDS_FIFO_CLR);
#endif
    for(uint8_t idx = 0; idx < 3; idx++) RDA5807Registers[idx] = swapbytes(RDA5807Registers[idx]);

    twi_writeToSlave(RDA5807M_I2C_ADR, (uint8_t*)RDA5807Registers, 6);

}

void RDA5807mPowerCycle(void)
{
	HAL_GPIO_WritePin(RDA_SWITCH_PWR_GPIO_Port, RDA_SWITCH_PWR_Pin, GPIO_PIN_RESET);
	PLATFORM_DELAY_MS(1000);
	HAL_GPIO_WritePin(RDA_SWITCH_PWR_GPIO_Port, RDA_SWITCH_PWR_Pin, GPIO_PIN_SET);
	PLATFORM_DELAY_MS(500);
}

void RDA5807mPowerOn(void)
{
	HAL_GPIO_WritePin(RDA_SWITCH_PWR_GPIO_Port, RDA_SWITCH_PWR_Pin, GPIO_PIN_SET);
	PLATFORM_DELAY_MS(500);
}

void RDA5807mPowerOff(void)
{
	HAL_GPIO_WritePin(RDA_SWITCH_PWR_GPIO_Port, RDA_SWITCH_PWR_Pin, GPIO_PIN_RESET);
}
