vladimirsustek/RadioServer/(commit log)

2022-07-16 Functiona stable 7-seg 4x digit LED display
2022-07-16 Fully functional VCOM cmd_dispatcher, output to LED
2022-08-11 Debugging DMA UART, working with parsing issues
    [cmd_dispatcher.c, esp8266_port.c, esp8266_port.h, gpio.c, ledc_if.h, main.c, main.h]
2022-08-13 Finalized UART esp8266_port
2022-08-14 Functional HHTP BluePill's LEDON/LEDOFF, needs re-struct
2022-09-02 EEPROM_Modul almost OK write and read
    [EEPROM_Modul.brd, EEPROM_Modul.sch, RadioRX.brd, RadioRX.sch]
2022-09-16 Cleaned HW, prepared for NCODER, time (slows 1minute/hours)
    [EEPROM_Modul.sch, RadioRX.brd, RadioRX.sch]
2022-09-20 Almost final state, just a 32.768 XTAL misses to be soldered
    [RadioRX.brd, RadioRX.sch]
2022-09-24 Full system, needed RDA voltage turn on/off
2022-09-30 By-Passed main:APP_UserInput due to being trigger when ESP_ProcessHTTP:Reset RDA Init and Rset modified
    [app.c, rda5807m.c, rda5807m.h]
